jaredjennings/dactyl-keyboard/things/case-right-4x6.stl

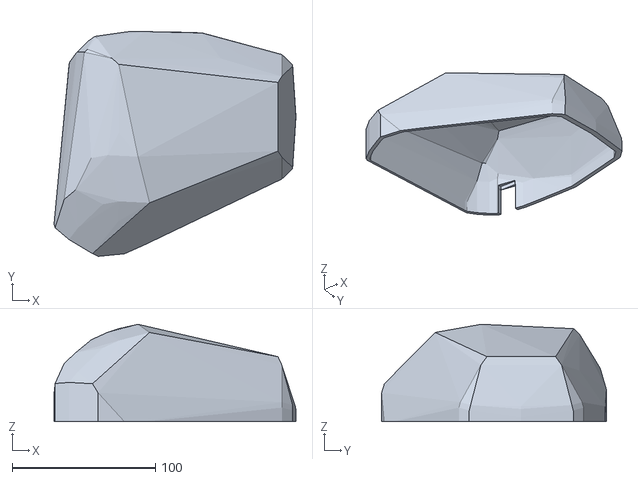
[picture p1: CAD file, 2021-05-06]
things/case-right-4x6.stl
169.1 x 157.1 x 68.1
