jaredjennings/dactyl-keyboard/things/left-6x6.stl

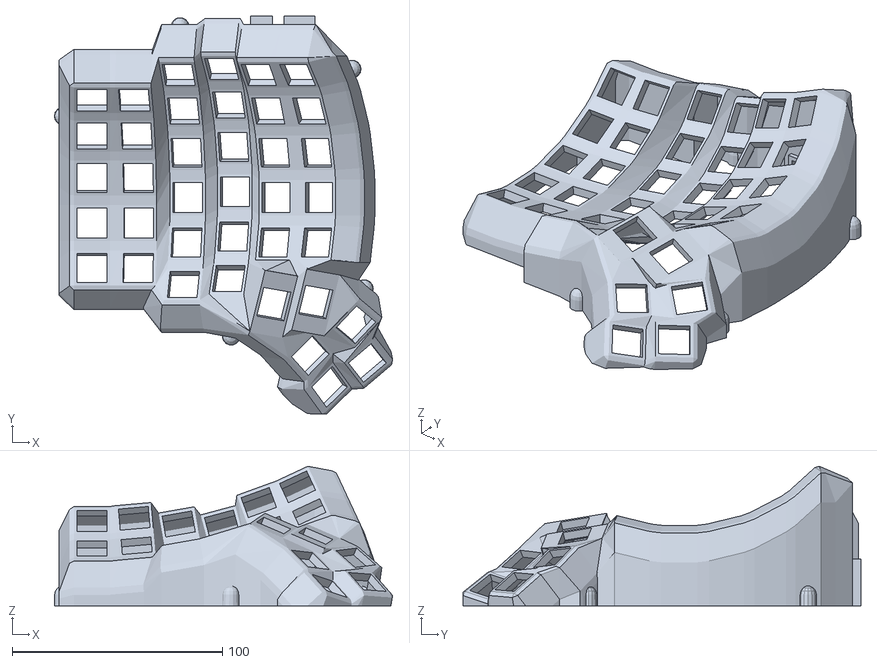
[picture p2: CAD file, 2021-05-06]
things/left-6x6.stl
161.1 x 189.5 x 66.4
