jaredjennings/dactyl-keyboard/things/case-left-5x6.stl

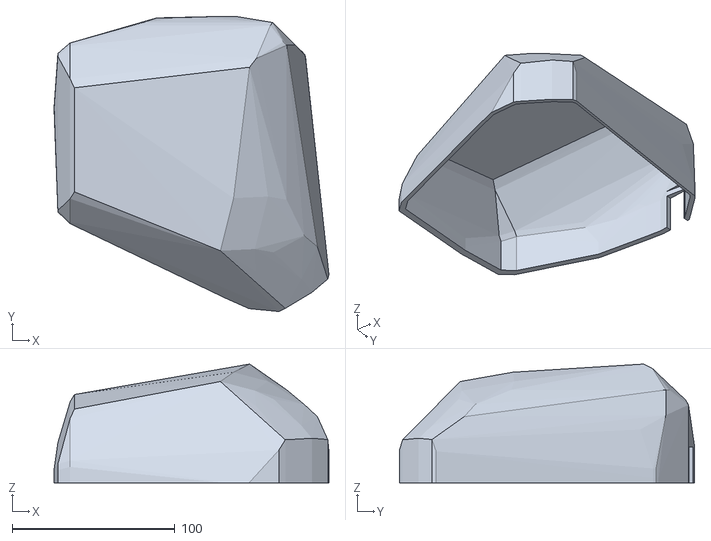
[picture p3: CAD file, 2021-05-06]
things/case-left-5x6.stl
169.1 x 181.5 x 73.1
