jaredjennings/dactyl-keyboard/things/right-4x5.stl

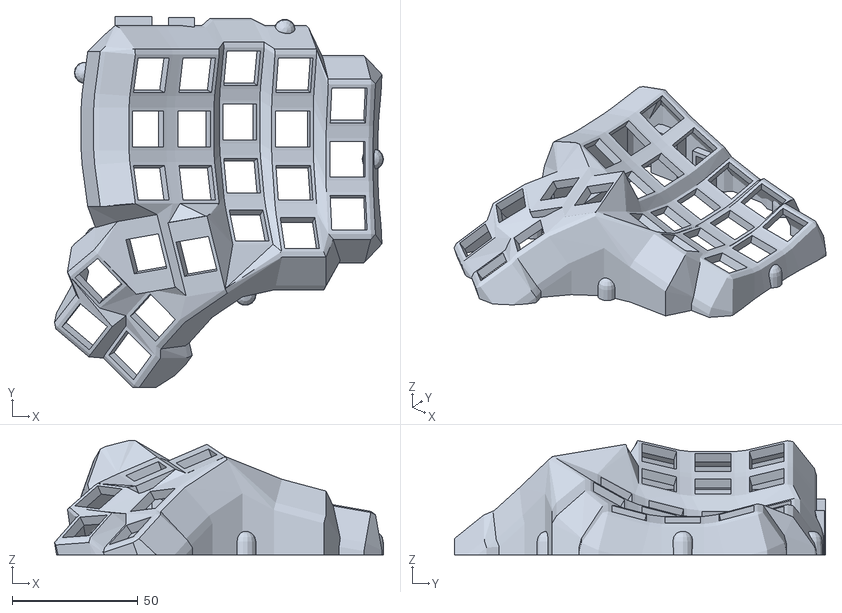
[picture p4: CAD file, 2021-05-06]
things/right-4x5.stl
131.0 x 147.9 x 45.6
