jaredjennings/dactyl-keyboard/things/case-right-6x6.stl

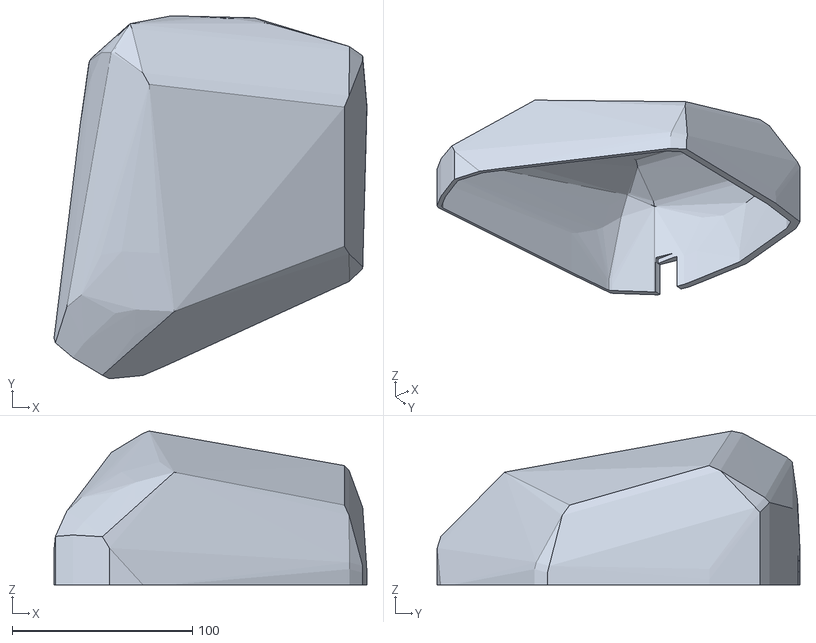
[picture p5: CAD file, 2021-05-06]
things/case-right-6x6.stl
173.9 x 201.4 x 85.5
