jaredjennings/dactyl-keyboard/things/right-5x6-plate.dxf

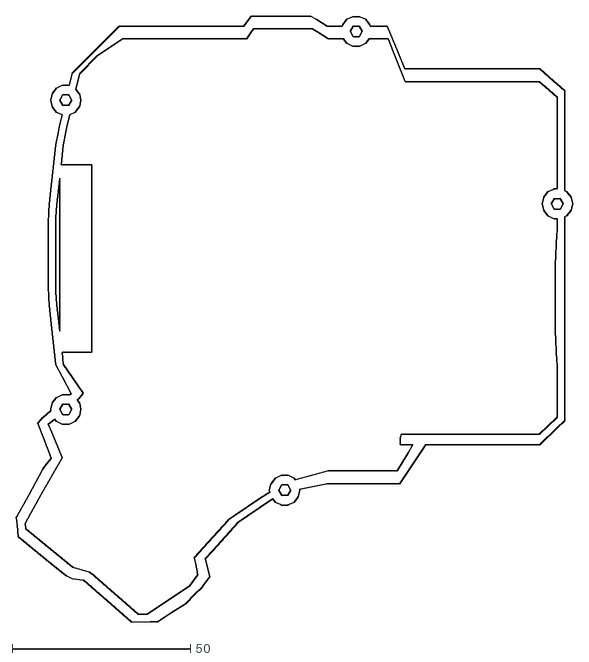
[picture p6: CAD file, 2021-05-06]
things/right-5x6-plate.dxf
155.8 x 169.8
