jaredjennings/dactyl-keyboard/things/right-4x6.stl

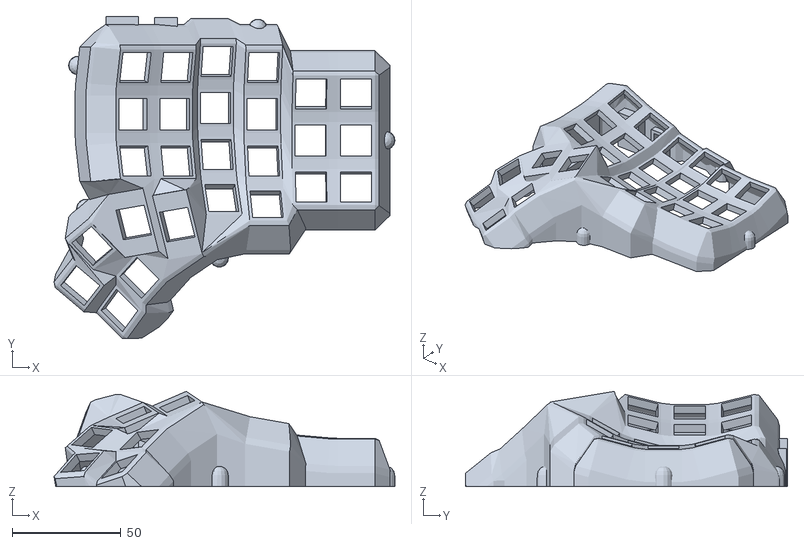
[picture p7: CAD file, 2021-05-06]
things/right-4x6.stl
156.6 x 147.9 x 43.8
