jaredjennings/dactyl-keyboard/things/right-6x6-plate.dxf

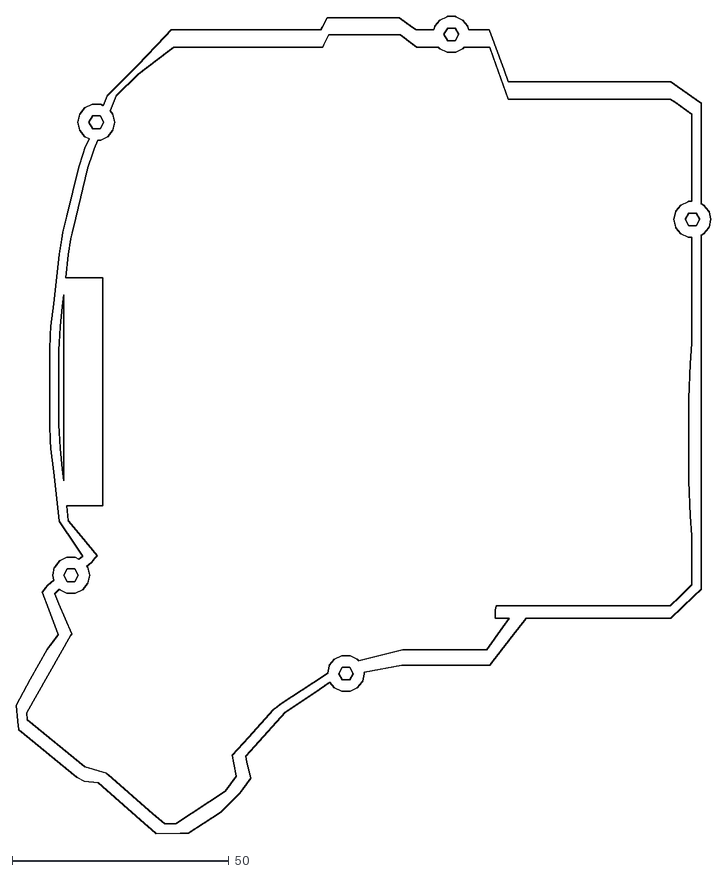
[picture p8: CAD file, 2021-05-06]
things/right-6x6-plate.dxf
160.3 x 188.5
