jaredjennings/dactyl-keyboard/things/left-5x6.stl

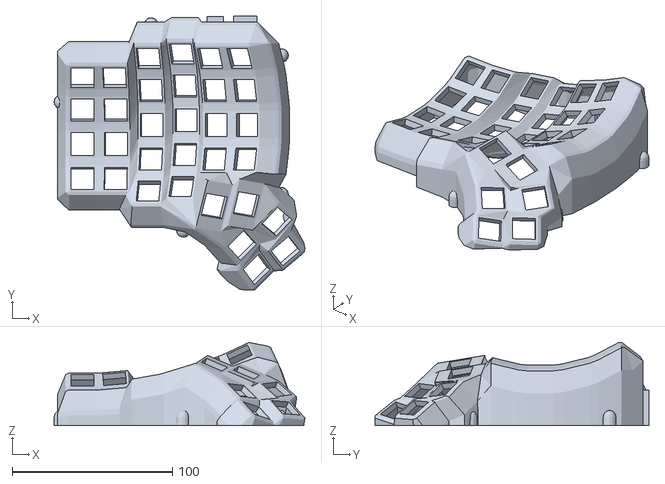
[picture p9: CAD file, 2021-05-06]
things/left-5x6.stl
156.6 x 170.8 x 51.8
