jaredjennings/dactyl-keyboard/things/case-right-4x5.stl

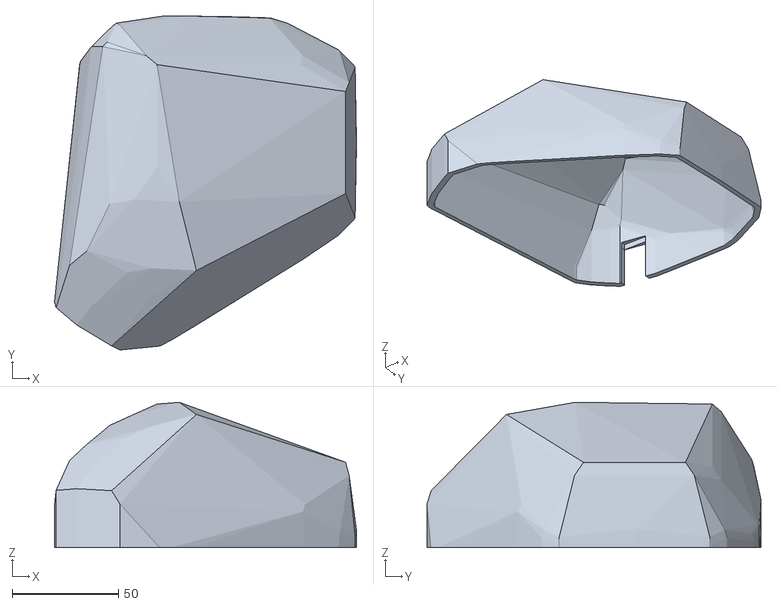
[picture p10: CAD file, 2021-05-06]
things/case-right-4x5.stl
142.1 x 157.1 x 68.4
