jaredjennings/dactyl-keyboard/things/left-4x5.stl

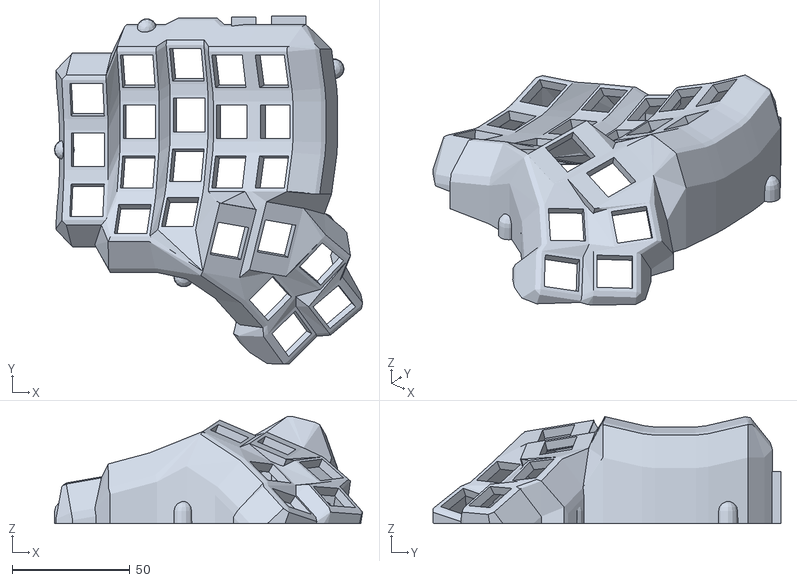
[picture p11: CAD file, 2021-05-06]
things/left-4x5.stl
131.0 x 147.9 x 45.6
