jaredjennings/dactyl-keyboard/things/right-4x6-plate.dxf

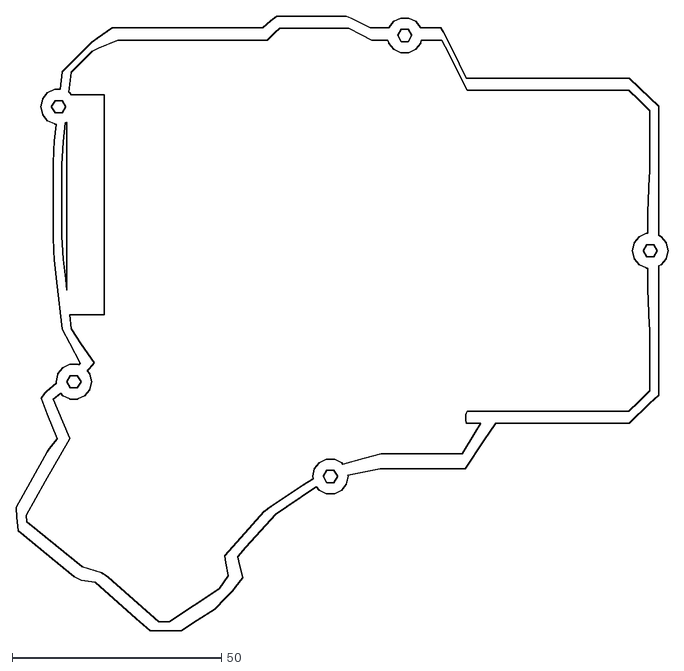
[picture p12: CAD file, 2021-05-06]
things/right-4x6-plate.dxf
155.8 x 147.0
