jaredjennings/dactyl-keyboard/things/right-4x5-plate.dxf

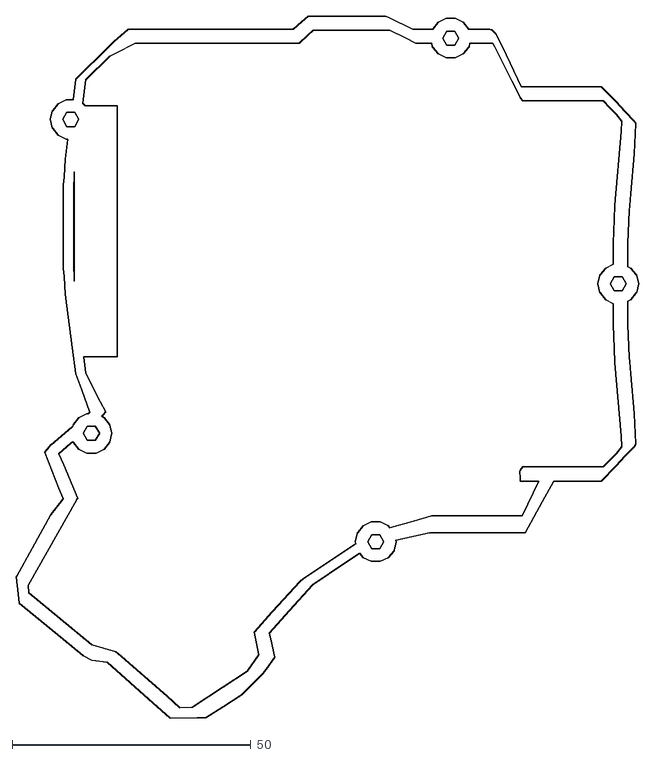
[picture p13: CAD file, 2021-05-06]
things/right-4x5-plate.dxf
130.2 x 147.0
