jaredjennings/dactyl-keyboard/(list of files, cad)

Other CAD files:
things/case-left-6x6.stl
things/case-left-4x6.stl
things/left-4x6.stl
things/case-right-5x6.stl
things/case-left-4x5.stl
things/right-5x6.stl
things/right-6x6.stl
