jaredjennings/dactyl-keyboard/(threads)

Thread 1 (2018-05-10):

feet

jaredjennings, 2018-05-10:
Add feet to the new bottom cover.

jaredjennings, 2018-05-27:
The feet story isn't over, but this is a start.

jaredjennings, 2018-05-27:
Oops, clicked while yawning.

jaredjennings, 2018-07-24:
[332b7ee] and the next five or so changes remove the solid bottom of [788c2eb], replacing it with legs that are separate pieces. Still no transverse holes. You know, I'm going to make that a separate issue, and call this one done.

Closed 2018-07-24.

Thread 13 (2018-05-10):

move code upstream?

jaredjennings, 2018-05-10:
Some of the 79 commits (at this writing) that I've done may be of general interest.

jaredjennings, 2018-05-10:
I looked through the commits. I think the only thing that really would go upstream is the renaming of the switch holes from "old" and "new" or whatever it was to "cherry" and "alps," and the addition of "kailh" without the nubs. But it's not clear that the way I did it is the way it should be done upstream.

Closed 2018-05-10.

Thread 14 (2018-05-10):

conventions

jaredjennings, 2018-05-10:
Use τ everywhere instead of π. Multiply by fractions instead of dividing. These and others like them are practices I've evolved over the past however long, which means not all the code follows them.

Thread 3 (2018-05-10):

rj-11 jack

jaredjennings, 2018-05-10:
Make a hole for an RJ-11 (modular 4P4C) jack, and figure out how the jack will be stuck into the hole.

jaredjennings, 2018-06-05:
I think it'll have to be glued in.

Thread 4 (2018-05-10):

attach bottom cover

jaredjennings, 2018-05-10:
The bottom cover needs to be attached to the frame. Probably by means of tubes run up from the bottom cover, with holes that those brass threaded inserts can be pushed into with a soldering iron. Also screw holes in the frame.

Closed 2018-05-31.

Thread 6 (2018-05-10):

Teensy bracket for LC

jaredjennings, 2018-05-10:
I bought a Teensy LC instead of a Teensy 2.0, because I felt like a renegade. This could have interesting firmware implications, but those are down the road. Right now, it's not quite the same size. Make sure it will work OK. Exact location is not important because of the Adafruit extension I bought.

And I think my code can either put a bracket on every piece of the frame or none. Look and fix.

jaredjennings, 2018-07-04:
Weeell, so far the dynamic behavior of the plastic hasn't been a consideration, nor the changes in its physical characteristics over time. Maybe I don't want to open that can of worms at this time.

jaredjennings, 2018-07-06:
OK, 9d0da13 adds the holder, but not the threaded-insert hole on the frame.

jaredjennings, 2018-07-06:
Ah, the holder should be centered on the screw hole, not the center of the Teensy board.

Closed 2018-07-07.

Thread 7 (2018-05-10):

thumb piece

jaredjennings, 2018-05-10:
A file is written for each finger piece (subset of columns), but none is yet written for the thumb piece. Fix.

Closed 2018-05-25.

Thread 8 (2018-05-10):

split bottom cover

jaredjennings, 2018-05-10:
The bottom cover needs to be split into pieces of suitable size, for the same reason as the frame and sides, i.e. to work on printers with a smaller build volume and so each piece will only take an hour or two to print.

Connectors should be added, to make it easier to glue.

This may end up with a need to define the cover piecewise, as it is with the frame and sides.

jaredjennings, 2018-05-23:
I tried immediately to define the bottom cover piecewise, and I started with the hardest piece: the one that includes the thumb. First I found that my definition needed to go one key place farther than my finished piece would, otherwise the piece would curve up at the edge. But then the interaction between the below-key prisms for the thumb and the finger, used for clipping the cover piece to size, got awkwardly 3D. I couldn't guarantee that one set of prisms would be exactly disjoint with the next, particularly around the upper left corner of the thumb.

So I removed my partial definition, resolving to intersect the entire bottom cover with several different prisms that cover the space, as was done with the sides before partially-defined sides entered the picture.

jaredjennings, 2018-05-27:
I did that, but quickly figured out that I'd need some slightly larger and slightly smaller prisms, so that I could define border regions and intersect them with connector shapes. That was not going to be easy - you can't just scale the prism, because it's defined somewhere else besides the origin.

Closed 2018-05-27.

Thread 16 (2018-05-13):

naming

jaredjennings, 2018-05-13:
There are several unfortunate naming decisions in the code.

Finger vs. thumb and key vs. thumb are one. I sort of like finger better, because after all the thumb has keys on it no less than the rest of the keyboard. I thought about having a configurable number of segments each with its own placement function, to get rid of all the hard-coding, but then decided this would only make sense if there were users with more than one opposable digit per hand. Not knowing of any, and not being one myself, this appears to be an unnecessary bit of (ahah) flexibility.

"Marshmallowy," "mallowy," "marshmallow," etc. were a more useful distinction when I was adding them into adereth's code and thinking of making them switchable; and the joy I felt at seeing them attached to my keyboard, and their roundness, reminded me of Homestar Runner saying, "marshmallow." But the adjective was always too long, and at this point it should go away.

There are three kinds of glue connectors at this point (well, two and a half), with another in the offing. The originals are stuck in dactyl.clj, as I recall to avoid circular imports. They need good names.

Thread 18 (2018-05-23):

make glue connector nubs slightly smaller

jaredjennings, 2018-05-23:
Not a lot. Just like a tenth of a millimeter. And only on the sides of the nubs: the height of the nubs is about right.

Closed 2018-05-25.

Thread 19 (2018-06-05):

add a flat place to clamp the thumb

jaredjennings, 2018-06-05:
The northerly glue paddle of the thumb angles up to the thumb frame, and there's no place for a clamp to press on. Add it so this paddle can be glued.

Closed 2018-06-11.

Thread 21 (2018-06-07):

bottom pieces too big

jaredjennings, 2018-06-07:
The second bottom piece took like 2 1/2 hours to print, with what turned out to be not nearly enough support inside. Split it in more pieces.

Closed 2018-06-07.

Thread 24 (2018-06-11):

frame-sides connectors missing from thumb frame

jaredjennings, 2018-06-11:
The thumb frame doesn't have any connectors on it.

Closed 2018-06-24.

Thread 25 (2018-06-11):

sides-frame connectors interfering with sides-sides connectors

jaredjennings, 2018-06-11:
The sides-frame connectors are too wide. You can't fit all the ones needed into the thumb part along with all the connectors between sides pieces. They only engage the frame-sides connectors along a fairly narrow strip. So make them narrower to match.

Closed 2018-06-23.

Thread 26 (2018-07-08):

USB bracket holes too small

jaredjennings, 2018-07-08:
It could be because they are pentagonal, or because I've confused their radius and diameter. But drilling one of them out didn't work well.

Thread 27 (2018-07-08):

too much downness

jaredjennings, 2018-07-08:
I finally got a piece of the sides and a piece of the frame that fit together. The sides piece was too far down: the keyswitch was visible below the keycap. Yes, some people like that, but that wasn't the idea for this keyboard.

Thread 28 (2018-07-08):

teensy holder slightly too small

jaredjennings, 2018-07-08:
Just got the Teensy pushed into the holder, and it doesn't quite close.

jaredjennings, 2018-07-24:
[0db44373dd] may be slightly too big. Find out next time

jaredjennings, 2019-02-08:
Pretty sure I got this dialed in right.

Closed 2019-02-08.

Thread 29 (2018-07-09):

clampability of bottom pieces

jaredjennings, 2018-07-09:
The bottom pieces need to be clamped together when they are glued. I just set two one on top of another when gluing, and they didn't quite mesh right and there are cracks. Such errors will certainly compound and result in a janky keyboard.

For pieces in the middle of the bottom, it's theoretically possible to clamp against something flat, although the vertical prisms are probably too big to actually do that. But pieces at the edge are angled up from the base toward the keyboard; there is nowhere for a clamp to gain purchase.

Two ideas I've had (thanks to other people at HackPGH) are to (1) make some kind of inverse of the side, whose outside is at right angles to the bottom; (2) add some kind of concave feature to the sides, where a clamp could gain purchase. It may in fact be necessary to do both: with an inverse piece made, why should it not slide against the side piece when they join at an angle? And this inverse piece should shy away from glue seams, so that if any glue gets out while the clamps are on, the inverse piece won't stick to the work.

In fact, up to now I've only thought of an inverse piece that encloses the whole side of the keyboard and is thus bigger than it; but maybe all that is necessary is some kind of straight-sided plug.

When I think of concave features, what I'm thinking of is a spherical dimple, maybe an inch around and a quarter inch deep. Once gluing is done, the dimple could be filled in in the Bondo stage (a thing I have not yet tried). But maybe if the feature is smaller in diameter relative to its depth - a quarter-inch cylindrical hole, perhaps? - less clamp slippage would occur.

Distantly a thought reoccurs. The first sides-to-sides connector I tried was some horizontal pins and holes. These failed miserably because the pins had to be supported, and the support was stronger than the pins and couldn't be removed. At the time, some people suggested I make holes on both sides and use pins of another material, such as metal. I kept iterating and came up with the hexagonal conical interface which is still unproven as a joint, but has turned out to be reasonably printable. But now imagine there are several holes that run horizontally through all the pieces of the bottom. Suitable interfaces are made for either end, with surfaces normal to the axis of the hole. The pieces are glued; interfaces and pieces are threaded on several threaded rods; washers and nuts are threaded on and tightened. Voila! Now, that only works for the present large block bottom. The original bottom was merely a curved panel, which would have feet of some sort attached; clamping things together in one axis when they are bowed out in another axis is a challenge. But the way we got to this bottom was by sidestepping the mystery of how the feet would look and how they would be defined.

Clear as mud what should be done, eh? But I had no other handy place to write these thoughts.

jaredjennings, 2018-07-12:
Ok - first we need smaller but wider vertical prisms: the places where they meet should have smaller teeth, but the pieces themselves shouldn't be much smaller.

jaredjennings, 2018-07-13:
OK, smaller teeth. Now the screw hole splits have teeth that are too small though

jaredjennings, 2018-07-13:
Is fix! So now we have more clampable sides pieces, but the problems with the ones on the end remain. And it's likely that the splits need to be tweaked again in order to avoid small shards of plastic at the edges.

jaredjennings, 2018-07-15:
I think it's time to hack in greater depth on the bottom. There is too much plastic there; it takes too long to print. Above provisions for clampability assume the current shape of the bottom, which needs to change. So I think I should change it, then consider clampability. And printability.

jaredjennings, 2018-07-16:
aaaggghhh this is why i left the bottom how it is for so long: change a single thing, wait *fifteen minutes*, repeat

jaredjennings, 2018-07-20:
Now the keyboard has legs [7898f325], which are a clampability issue of their own. But first the legs need glue tolerance.

jaredjennings, 2018-07-20:
ok glue tolerance added

jaredjennings, 2018-07-20:
The bottom pieces should now print in a finite time. But now they are less clampable than ever!

jaredjennings, 2018-07-21:
Now I'm thinking of some cutouts near the joints between bottom pieces. Home-plate-shaped, with the flat bottom parallel to the joint; in pairs, one on each side of the joint. Such cutouts could be clamped using spring clamps, which have been easy and successful in gluing the frame pieces together. The distance across which the clamp presses would be minimized, so the instability of pressing curved things together would be minimized. I can imagine a way to make home-plate-shaped inserts that can be glued into the cutouts. But maybe if I get smaller spring clamps, I can have smaller cutouts, and fill them in with Bondo or something.

jaredjennings, 2018-07-24:
I set out to print dactyl-bottom-00a, 00b, and 01a with lace holes. At 0.5mm radius, some of the holes were filled in. Nothing a hot wire can't fix, but gluing is enough postprocessing, without drilling out holes too. Aaand 00b failed to print like three or four times, so I don't have two pieces that go together that I can try lacing.

jaredjennings, 2019-02-07:
["Hah! We're back!"](https://www.cartalk.com/content/hah-were-back) I've got my own printer now and things are great. Issues still with the joining of the bottom pieces, but not with the means of clampability - I've laced up two pieces and glued them with SciGrip 4 to great effect. Closing this one then.

Closed 2019-02-07.

Thread 30 (2018-07-11):

that one weak spot in the thumb

jaredjennings, 2018-07-11:
one of the holes for the stabilizers in the thumb is lacking most of one of its sides. find and fix

Closed 2018-07-14.

Thread 31 (2018-07-13):

screw hole not deep enough

jaredjennings, 2018-07-13:
The screws I got are slightly too long to go through the frame and stop before the end of the threaded insert. So you screw the screw in as far as it will go, and it doesn't hold the frame tightly against the screw hole.

(And the hole in the plastic already wasn't quite deep enough for the insert to be pushed down far enough to be flush, by a half millimeter or so.)

Consequently the ... how you say, boss, in the screw-hole, needs to be deeper.

Closed 2018-07-15.

Thread 32 (2018-07-13):

frame-sides connectors not clampable

jaredjennings, 2018-07-13:
The frame-sides connectors with their angled interface to the frame look good and are well-printable, but cannot be clamped against. Make them boxier.

Closed 2018-07-14.

Thread 33 (2018-07-24):

sides and bottom different thicknesses?

jaredjennings, 2018-07-24:
The sides printed at 3mm thickness (well, the one piece I have) are satisfyingly solid but take forever to print. So I reduced the sides-thickness to 2mm. But then I printed the new, legs-having bottom, and it was a wide expanse of plastic 2mm thick, which turns out to be quite flexible. The possibility remains that when glued together several pieces of this stuff will be stiffer; but the possibility also remains that I'll drop it some day. On the gripping hand, neither will happen if the pieces take so long to print that I never have them in hand.

Anyway, I still haven't tried the sides at 2mm, nor the bottom at 3mm. Having these values independent might be helpful.

Thread 35 (2018-07-24):

put a raspberry pi inside

jaredjennings, 2018-07-24:
Get a Pi Zero W and a battery. Stuff them inside the keyboard. Run connectors (e.g. charging, video) to the edge of the keyboard. Figure out how to put some part in the left hand too so the right hand isn't markedly heavier.

jaredjennings, 2018-09-21:
https://reddit.com/u/ILWrites is designing this sort of thing, really thoroughly it appears, although of course not for my particular keyboard.

e.g. https://www.reddit.com/r/MechanicalKeyboards/comments/9dhhj1/quick_update_on_the_mk_project_ive_been_working/

Thread 37 (2018-07-25):

smaller edition

jaredjennings, 2018-07-25:
The really small one (what, 2x2 finger) never really worked right. It wasn't a serious effort, just an attempt to reduce rendering times. But there should be a smaller size - what, 3 rows by 5 columns, or so? - it would probably work better, and some people would want it, and maybe its pieces will print faster...?

jaredjennings, 2018-07-25:
Created #38 about the thumb.

jaredjennings, 2023-05-03:
Boy howdy, I tried 5 columns - twice now - and I didn't like it.

Thread 38 (2018-07-25):

Vary thumb

jaredjennings, 2018-07-25:
The thumb is hard-coded. I don't think it can be shoehorned into maps and lists like the description of other parts of the keyboard found in the layouts variable in layout.clj; but it should be factored and packaged so you can at least write another thumb, and say this layout has thumb A and this one has thumb B.

jaredjennings, 2018-07-28:
Ok wow #37 and this one are causing some second-system effects for me.

As against what Adereth wrote, a big part of what I've done is to try to pull out constants and put them in one place, with the idea that they could be swapped out wholesale. This has led my thoughts in the direction that the constants written in layout.clj are the definition of a keyboard, written in a highly domain-specific, very-low-abstraction-power language. There are two problems here: (1) the feeling that my Lisp program ["contains an ad-hoc, informally-specified, bug-ridden implementation of Lisp"](https://en.wikipedia.org/wiki/Greenspun%27s_tenth_rule); (2) the thumb is written in a lower-level, high-abstraction-power language.

Every time I try to think seriously about fixing this (in the last few days), I end up thinking larger thoughts instead: either (1) that the whole idea of the constants is wrong, and this top level of keyboard abstraction should be made out of macros or functions or something; or (2) that I haven't gone far enough, and I need to distill more ideas about how to specify the essence of a keyboard apart from the shapes that make it up. But I'm on shaky ground: (1) the constants are not in fact all in one place at all, I've defined more that are scattered through the code; (2) there are many hacks: the added block for the thumb glue connector to make it clampable, the extra keys specified in the prisms that cut out the inside of the sides gasket, and such like.

jaredjennings, 2018-07-31:
Actionable problems:

1. The thumb contains rotated keys and keys of different sizes. These must be connected by different connectors.
2. The connectors between the thumb and finger are a special case.
3. Irregularities in the key prisms regarding the thumb.

jaredjennings, 2019-05-20:
I finally have an answer for (1), I think. The things defined in layouts seem tantalizingly like a declarative description of a keyboard aching to become code, but the way they are used is as data. With code, if you remove some of it, it doesn't execute, or describe, or whatever the code does. And it only gets called when you call it. But this is data: it is accessed from all over the place, unpredictably; if you don't write some of it, you get errors, because things requested are unset. It is a form describing the particulars of your keyboard, handed to a rigid, predefined process. Only in the ways the process has been made flexible is it flexible. And the process is what makes it a Marshmallow. The hacks may be feasible as hooks: code, but at the call of the rigid process; directions written into a long blank on the form. Put this way, it all seems bureaucratic, not elegant; but with the lengthy form it is after all more flexible than what I started with.

Thread 39 (2018-07-28):

make it a container

jaredjennings, 2018-07-28:
I didn't mind getting Clojure and OpenSCAD running, but it could be a barrier for someone. And if this program ever gets as flexible as I imagine (#37 and #38 are only the beginning, but probably not as flexible as https://github.com/HalFrgrd/UniversalKeyboardDesigner/blob/master/README.md), it would be annoying putting all the scad and stl files in the repo and keeping them up to date.

It's not that much easier or less developerish to get Docker running, so I guess the idea with making all this into a container would be to make a web app of some sort that would generate the STL files for a keyboard in your choice of forms: size of the finger part (number row? F-key row? extra Y and B keys?), shape of the thumb part (less keys, more keys, 2u or 1u keys, maybe manuform), shape of the sides (sphere, cylinder, octahedron, etc), column staggering amounts; and cache them so people can link to them with a really long URL, like you can with KLE.

This would cost money to host, and it is a great deal of work on top of the keyboard itself, and I don't know if anyone actually wants it, and I don't know if I'm the person to make it for them even if they do. But now, having written this idea out, I can safely forget it and think of other things.

jaredjennings, 2020-08-18:
http://dactyl.siskam.link exists

Thread 40 (2018-08-20):

changing downness has broken sides

jaredjennings, 2018-08-20:
The half-circle connectors between sides pieces, and the sides-to-frame connectors, appear to be constructed incorrectly, because changing the downness of the sides has ... made these pieces work wrong.

Thread 42 (2018-08-21):

curvy vertical prisms?

jaredjennings, 2018-08-21:
The vertical prisms yield pieces with points and edges. These tend to be exaggerated by the 3D printer, leading to surfaces that contact each other only poorly, and are difficult to improve by sanding.

Try adding more polys to the vertical prisms, to make them curvier; see if this yields a better fit.

jaredjennings, 2018-08-21:
Also if you have more lace holes (#43) you have more places where the orderly flat and angled vertical prisms are interrupted

jaredjennings, 2018-08-25:
Ok, hacking the hexagonal vertical prisms into sinusoidal ones worked initially, but then making those bumps appear where I wanted on the half-circle connectors (#44) proved to be very difficult, and involved factors and addends that, for example, changed when I changed the period of the sines, or when I changed the resolution of the thing. And it was slow. So I'm undoing the whole thing, reopening this issue, and I'm going to do the work in a branch.

jaredjennings, 2018-09-11:
The commits of the eggcrate-splitters branch, just merged, fix this properly.

Closed 2018-09-11.

Thread 43 (2018-08-21):

more, smaller lace holes

jaredjennings, 2018-08-21:
I glued together a couple of pieces with the current set of lace holes. The laces were easy to thread, and I think the joint may have worked (one of the pieces is much weaker than the joint so it's hard to tell), but the laces ran along the pieces more than across them, such that the force of pulling the laces was poorly converted into force pulling the pieces together.

jaredjennings, 2018-08-25:
See https://github.com/jaredjennings/dactyl-keyboard/issues/42#issuecomment-415967898. Reopening, backing out, and redoing the work in a branch.

jaredjennings, 2018-09-11:
The commits of the eggcrate-splitters branch, just merged, fix this properly.

Closed 2018-09-11.

Thread 44 (2018-08-21):

use vertical prisms for half circle connectors

jaredjennings, 2018-08-21:
If sharp points aren't good for the connections between pieces of the bottom (#42), then they aren't good for the connections between the sides either. And those darn cones never quite lined up right anyway. Use the vertical-prisms surface for the connections between sides, in the same way as they are used for the screw holes. Then any advancements made will apply to nearly all the connections in the keyboard. (The glue paddles are too small and thin to use this design.)

jaredjennings, 2018-08-25:
https://github.com/jaredjennings/dactyl-keyboard/issues/42#issuecomment-415967898. This is the thing that wouldn't work given the way I had hacked the curvy bits onto the vertical prisms.

jaredjennings, 2018-09-11:
The commits of the eggcrate-splitters branch, just merged, fix this properly.

Closed 2018-09-11.

Thread 45 (2018-08-25):

with hacky curvy vertical prisms, sides-to-frame connector borked

jaredjennings, 2018-08-25:
This should work itself out as the rewritten eggcrate box is integrated, but it's an issue.

jaredjennings, 2018-09-11:
The commits of the eggcrate-splitters branch, just merged, fix this properly.

Closed 2018-09-11.

Thread 46 (2018-09-03):

Combining with RollerMouse Red

dfenn, 2018-09-03:
I'm interested in how you've split this up into pieces. I have a 3D printer with a small printing volume, so the only way I'd be able to print it would be in pieces.

I'd like to combine a Dactyl with the RollerMouse Red (https://www.contourdesign.com/product/rollermouse-red/). To do that, I think the roller would have to butt pretty close up against the thumb cluster, so that the keyboard wouldn't be too far away.

I think that to do that, it would be necessary to remove the marshmallow part on the front edge, and the height may have to be adjusted. I've looked through the source files, but I'm not sure where to start to accomplish these.

Can you give me any pointers about how I might accomplish that?

Thanks!

jaredjennings, 2018-09-04:
@dfenn, welcome! The height is adjusted in things/key-place.scad in the KeyPlace and ThumbPlace modules. Since it's raw OpenSCAD code, if you adjust it while you have dactyl-top-right-all.scad open in OpenSCAD, you'll see the changes immediately.

For the marshmallow part, first you would need to make the sides not go all the way around the keyboard, and then you'd have to figure out how to split the resultant sides in pieces and how to attach them.

The sides are defined in sides.clj; right at the end, [`sides-right`](https://github.com/jaredjennings/dactyl-keyboard/blob/11f57b17ae8c23b1b7689550111812c5fe6c5862/src/dactyl_keyboard/sides.clj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) is defined as a closed sides object (last argument true) whose, ah, shall we say points, are `around-edge`. You probably want to make a copy of [`:around-edge`](https://github.com/jaredjennings/dactyl-keyboard/blob/11f57b17ae8c23b1b7689550111812c5fe6c5862/src/dactyl_keyboard/layout.clj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), which is in layout.clj's `:y-and-b` layout, and call it `:sides-exist-at` or something. (`layouts` was supposed to be a way to define multiple sibling keyboards, e.g., different sizes, and choose one to render. That has not happened yet. See #37 and #38.) [Below the `def layouts`](https://github.com/jaredjennings/dactyl-keyboard/blob/11f57b17ae8c23b1b7689550111812c5fe6c5862/src/dactyl_keyboard/layout.clj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), around line 100, are a bunch of mentions of `chosen-layout`. That's how the key `:around-edge` in the `:y-and-b` layout becomes the global variable `around-edge`. So add a new def there for `sides-exist-at`. Now make `sides-right` at the end of sides.clj use `sides-exist-at` instead of `around-edge`, and pass false as the last parameter because your sides shape is no longer closed.

To change how the sides are split into pieces, change [`:sides-partitions`](https://github.com/jaredjennings/dactyl-keyboard/blob/11f57b17ae8c23b1b7689550111812c5fe6c5862/src/dactyl_keyboard/layout.clj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) in layout.clj (see output file `splits-right.scad` for the results of your changes), and change `:sides-slice-joints`, immediately following, to match.

The sides are glued to the frame using the [`:sides-frame-joints`](https://github.com/jaredjennings/dactyl-keyboard/blob/11f57b17ae8c23b1b7689550111812c5fe6c5862/src/dactyl_keyboard/layout.clj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). Some of these will no longer join the frame to anything once you have removed the front of the thumb, so you'll have to change them.

All of these things are specified using a family of rather compact notations. The somewhat exact meaning of the `:sides-slice-joints` notation, for one, is [in the docstring of `intersects-from-notation` in sides_pieces.clj](https://github.com/jaredjennings/dactyl-keyboard/blob/11f57b17ae8c23b1b7689550111812c5fe6c5862/src/dactyl_keyboard/sides_pieces.clj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). `:around-edges` notation eventually gets passed to [`sides-place-fns`](https://github.com/jaredjennings/dactyl-keyboard/blob/11f57b17ae8c23b1b7689550111812c5fe6c5862/src/dactyl_keyboard/layout.clj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), and is documented there.

Generally, though, `k` means key-place, and `t` means thumb-place. On the right side of the keyboard, which is the primary one modelled, `k` column numbers (-1 through 5 inclusive, see `:columns-pieces`) go up as you go to the right (aka east), and row numbers (0 through 4 inclusive, see `:rows`) go up as you move away from the user (aka north). `t` column numbers (0 through 2 inclusive) go up as you go to the left, and row numbers (-1 through 1 inclusive) go up as you move away from the user. The details, like `[:n :k 3 2]` or `[:w-of-k 3 2]`, are modifications of those places on the keyboard, inexpertly specified.

Hope this helps; please ask more questions.

(You know, looking at it from the top, you might want to shave some of the marshmallow off of the near right corner too... hmm.)

dfenn, 2018-09-05:
@jaredjennings, thank you for the detailed response. I'm hoping to have some time this weekend to look into this. I'll keep you posted on how it goes, and I'll ask you more questions as necessary.

Thanks!

jaredjennings, 2018-09-09:
I've done the first part of this in 62da0d1ceb3b29cdbd01853ff356c28cdd277459 (no attention to how the sides are split into pieces, nor attached to the frame). This brings up the issue that the bottom is still defined under a place where the sides don't exist -- screenshot: https://imgur.com/Ksts5kO.

jaredjennings, 2018-09-18:
A possibly simpler thing to do is to change the shape used to form the marshmallow. Twice in sides.clj, the form ```(sphere r)``` occurs. If you change that to, say, ```(scale [0.5 0.5 1] (sphere r))```, it doesn't stick out as far in front of the keyboard. (Nor as far out from any of the sides.) Any convex shape will do - I've tried it with cubes and cylinders of various rotations, too. The reason it has to be convex is that a piece of it is hulled with a connector body to make the sides-frame connector, so if it's concave, you'll have bumps on the outside wherever there's a connector.

You know, it might be fun to vary the shapes hulled by position. If you were to use a cylinder rotated onto its side for the southernmost positions, you could achieve a flat front while still having the case exist there, and it would probably blend well with the spheres used everywhere else. (To be clear, the code as it stands doesn't support that. But it would be a pretty small change.)

dfenn, 2018-10-01:
Sorry for the novice question here, but how do you view the side pieces? When I view the sides-right-0*.scad files, not much shows up. It just looks like some very small pieces.

Also, are the sides required for structural support, or are they purely aesthetic? If they're just aesthetic, I may try doing a preliminary print without them just to see how the keyboard would feel with the RollerMouse. I'd rather not invest a lot of time tweaking things if it turns out that the Dactyl and the RollerMouse are going to be a bad combination anyway.

dfenn, 2018-10-02:
Turns out that was user error on my part. This is the first time I've used OpenSCAD, and I didn't realize there was a difference between previewing and rendering. The previews weren't working right, but as soon as I rendered, I was able to see everything fine.

jaredjennings, 2019-12-29:
Closing due to inactivity.

jaredjennings, 2021-11-05:
https://www.reddit.com/r/ErgoMechKeyboards/comments/qmujxm/lily58_wireless_with_rollermouse_setup/

Closed 2019-12-29.

Thread 48 (2018-09-15):

lace holes in the wrong places

jaredjennings, 2018-09-15:
When I made the eggcrate-splitters, I left some room between where the eggcrate splits the plastic in two pieces and where the holes are where you lace the pieces together while gluing.

One problem has shown up two ways: I printed the first bottom piece, and it had holes on its left edge. This means it isn't wide enough, and it also means the lace holes need to be closer to the split.

jaredjennings, 2018-09-15:
Oh and the last piece has a couple of little bites out of it because the last double eggcrate box doesn't cover the rightmost edge entirely

jaredjennings, 2018-10-01:
OBE #50. There will be another "tweak hexagonal pieces, splits are in the wrong place" ticket.

Closed 2018-10-01.

Thread 49 (2018-09-15):

eggcrates too small on sides-frame joints

jaredjennings, 2018-09-15:
After eggcrating the sides-frame joints and printing once, I find that the waves have too great frequency.

Closed 2018-09-15.

Thread 50 (2018-09-23):

hexagonal eggcrate splitters

jaredjennings, 2018-09-23:
Presently the eggcrate splitters are shaped sort of like eggcrates: wide, deep, but not tall; the bottom of each tray fits into the top of the next. Only they are stacked along the x-axis not the z. Their effect is to slice the bottom of the keyboard into long, thin strips. I've spent many evenings trying to tweak their thickness and offset (and the similarly shaped but pointier triangular-wave-oid splitters before them), such that there are no bites taken out of the leftmost or rightmost edge of the bottom, and no little bits hanging off the edge of any of the pieces, or even floating in midair. Every tweak takes like 10 minutes to show up, by which time I've moved on to something else and don't get back to it until 20 minutes later. And whatever OpenSCAD has to do to figure out how it's shaped, there isn't a progress bar for that.

I wanted to minimize the number of glue joints used for the bottom, and simplify them as much as possible, but the larger I make the pieces, the longer they take to print. And every piece (except for the first one, which is mostly the part of the thumb that sticks out) is as long as the whole depth of the keyboard (north-south). If I print it standing up to reduce the time and plastic taken up by printing support, the layer lines go across the width of the piece rather than along its length, making it weak.

So the bottom needs to be split along more than one axis. To just split it into rectangular pieces may not be the best, because four would have to meet in one place, and that place could be troublesome. With triangular pieces, six meet in one place. With hexagonal pieces, though, only three meet in one place. - Come to think of it, by alternating splits, like bricks are laid, you could have only three rectangular pieces meeting in one place. Meh, hexagons are cooler.

jaredjennings, 2018-10-01:
The egghex branch has been made, and merged. It has not been extensively tweaked, and OpenSCAD still takes 10 minutes of unresponsiveness per open bottom section. There are divisions that run through screw hole bases. We'll leave those for other tickets though.

Closed 2018-10-01.

Thread 51 (2019-02-07):

join bottom pieces better

jaredjennings, 2019-02-07:
So I made the bottom pieces bigger [7da24ba], since I don't have to stop printing, clean up and ride home cause I got my own printer. But the waves at their joints are too small to sand, and when I do, too much of them is removed. They need to be bigger. The reason I made them smaller is to obtain more precise alignment of the pieces, particularly vertically. But little imperfections in the print spoil the alignment.

So bigger waves. Would rotating them work better for vertical alignment? Or maybe they should be polar? A more complicated wave than a sine? Maybe I should cut irregularities with a little cutting bit, instead of trying to sand them? I need a good way to find them first. Like when you go to the dentist, they do something to your teeth, and then they check your bite with carbon paper and grind down here and there till all your teeth fit together just right again. Except my plastic is presently black. Powder of some kind? Flour?

jaredjennings, 2019-05-19:
Making the waves gentler just let pieces shear against each other in the z axis without anything to stop them. I'm using Sci-Grip 4 now, which solvent-welds the pieces; I'm not sure whether it softens them where applied, but it ought to. Also filing everything is annoying and doesn't always make it fit better. Sometimes there are gaps, even without having filed much material off. The Fourier box https://gitlab.com/jaredjennings/fourier-box has this problem, but I spent 30 hours printing it so I'm just going to make it work somehow. Probably with epoxy.

jaredjennings, 2020-09-20:
The way I solved it with the Fourier box was with friction welding. I clamped the pieces together, friction welded the entire seam on one side, friction welded a dotted line on the other side, and squirted Sci-Grip 4 in using a little bottle with a syringe tip. I got too happy with the clamp on one joint, and the resulting box failed to be flat. It still works, but it's not that great.

So I'm not still doing a pieced bottom, because I'm not doing an extra column anymore, so fingers crossed the whole bottom fits on my printer. My leading hypothesis about how to proceed with piecing is to stop trying to make the pieces contact each other across the whole joint, and instead make some sort of alignment jig that fits into the pieces in small places, like a big asterisk whose points are small balls that fit each into dimples on the model. *handwave* This then is what puts the pieces in the right position and orientation relative to each other, rather than the surfaces of the joint. Then friction weld the joint, to fill in plastic, then Sci-Grip it for good measure. Oh - 3D pens are also a thing - I saw a guy who matched two broad flat curved surfaces by scribbling across the joint with a 3D pen. I don't have one of those.

I haven't tried any of that above, so it might be another six-month boondoggle. As long as it's not in the way of making a keyboard, I'm not doing it yet.

jaredjennings, 2020-09-20:
I'm going to close this so I don't get demoralized by all the open issues. Then later when I'm dealing with pieces again I'll fish it out and reopen it.

Closed 2020-09-20.

Thread 52 (2019-03-21):

continuous curvature

jaredjennings, 2019-03-21:
Thatothermofo has brought to my attention the idea of continuous curvature in product design. https://www.reddit.com/r/MechanicalKeyboards/comments/b3soxi/once_youve_seen_it_you_cant_unsee_it/

At present there are discontinuities in the curvature of the sides and bottom of the keyboard at every point.

To fix, stop taking the hull of this and that, and instead define their shapes as continuous functions, whose first derivatives are constrained to be zero, for example, within 3mm of a keyswitch hole. Stopping using hull would enable the use of Five to model the keyboard, although defining and evaluating such functions as these make me think more of solving than drawing or describing. Either way it may be so much change as to compel a completely different project.

jaredjennings, 2019-05-18:
With the experience of https://gitlab.com/jaredjennings/fourier-box, I can say this could probably be done with some Bezier patches fairly easily, and in OpenSCAD. That would surface the old problem, though, that key-place is a function that translates objects, and not a function that transforms point coordinates. Bezier patches need points. Also the look of the keyboard would be determined by the positions of control points, rather than the shape used for pairwise hulling. And there could be some (if you will pardon the pun) corner cases, too...

jaredjennings, 2019-12-29:
So I tried this in Five. It turned out to be sort of easy to write a function that could displace an axis-aligned slice of any shape, so as to deal with the column staggering. I got it to use a piece of sine wave to interpolate between the non-displaced and displaced parts. Then I figured I would write another function that takes something flat and curls it up at the edges. This was quite difficult and I never succeeded at it. You can't abstract things very much in libfive, because it takes the code you write and translates it into a tree of C++ objects, and all the objects have to do directly with math on x, y, and z; so I couldn't take tricky or repeated bits and put them in functions. I tried some macro magic, which did not ultimately work.

And then I started browsing patents. I found the old IBM patent, where the columns grow apart from each other as you go north (my term not theirs) on the keyboard. I found the idea of columns whose profile is spiral not elliptical, because the joints of the finger place the tip of the finger along a spiral as the finger is curled up, not along an ellipse. And this let me know that all the work I'd done to curl up a flat shape along the surface of an ellipsoid was not as well-founded and invariant as I thought. That means I need to think about the shape of the keyboard more before I use something as brittle as libfive to express it. And that means work for this issue takes a hiatus.

jaredjennings, 2021-07-04:
https://www.reddit.com/r/ErgoMechKeyboards/comments/oc68nu/blended_dactyl_manuform_new_variant_written_in/

Thread 53 (2019-03-25):

export complicated mid-build objects to STL

jaredjennings, 2019-03-25:
I'm watching four ```openscad --render```s trundling away and pondering about how all four are thinking about what the bottom of my keyboard is shaped like. It's a big waste of effort, and it means a lot of time is wasted too. I'm just playing with the parameters that describe the edges of the pieces of the bottom, trying to arrive at values that reliably result in pieces that fit together with a minimum of postprocessing. Every time I do, I need to wait like ten minutes for the scads to build into stls. If only OpenSCAD had some kind of restart file like CFD solvers do, and I could tell it in some way that this piece of the bottom and this other piece of the bottom differ only in which piece got cut out, not what the bottom is shaped like.

Well - such a file exists: it is an STL file. If I rendered the whole bottom in one STL file, the pieces of the bottom would be defined like

```
    intersection() {
        import("bottom.stl");
        hex_prism_of_grid(...);
    }
```

Easy peasy, then I just have to write a few more dependencies in the build system (```dm-r-bot*.scad``` now depend on ```dm-r-botwh.stl```, or some such). And it ought to be a lot faster too, what with only figuring out what the bottom is shaped like once. The same could be applied to the sides.

I've exerted so much effort to push parts of the definitions of these complicated objects down into SCAD code, but never thought of pushing it all the way down to an STL. How silly of me!

jaredjennings, 2019-05-18:
Ok, b1e7d09 builds all STLs (for both hands) in 56 min, where 1283c8a built in 129 min. That's good.

I thought about doing this with the sides, too, but I already did that thing where I defined pieces of the sides rather than the whole sides. It's fairly likely that if I undid that and used intermediate STLs instead, it might be faster, and would very likely be simpler.

That work should probably happen in a branch. I'm going to leave this one open till I try it, but I may not do that immediately.

Thread 54 (2019-03-30):

registration widgets

jaredjennings, 2019-03-30:
The bottom of the keyboard has somewhere from 3 to 15 pieces (depending on how big I tell them to be). Other than all of them being just the right size and also fitting together perfectly (hah!) I don't know how I'll know they add up to the right size and shape.

If there were a hole, or a bump, or something, in the middle of each bottom piece, I could measure their distances, find out what a ... what a sanding and gluing job I did, and get better at it. I could even imagine printing jigs that mate with these registration widgets, and are easier to 3d-print and get right; when gluing some bottom pieces together you could attach the jigs, then remove them when done.

jaredjennings, 2019-03-30:
OK but if they are holes they have to be normal to the surface, not vertical. - Spheres don't change under rotation. Spherical dimples would only have to go in the right position. I think I wanted holes I can fit my vernier caliper into, though. With any kind of dimple or bump, where exactly on the feature should the caliper jaws go? But the holes must not be exactly normal: the sides of corresponding holes must be parallel. If they are both normal to the surface, they will be at angles to each other.

jaredjennings, 2019-03-30:
This is to say nothing of the problem that sank the clamp holes idea: there's already stuff on both the top and bottom surface of the bottom piece; any holes or bumps should avoid these existing features, and then how do you properly express where the hole or bump goes, without trial-and-error manual positioning? And such work would be instantly wasted if you change the size of the bottom pieces, which I've done a lot to trade risk of piece misalignment against time to print and iterate.

jaredjennings, 2019-06-10:
Weak idea: small spherical dimples the size of BBs. Buy AirSoft plastic BBs and glue them into the dimples. Use the calipers on the glued BBs.

Thread 55 (2019-04-27):

reduce leg sinusoid amplitude

jaredjennings, 2019-04-27:
Having glued a few legs on, I can see that there is not much contact area between the leg and its base. Make the joint less waffly and more flat. Not all the way flat but flatter. The period of the waves is about good - some two complete waves across a diameter of the leg. Just lower the amplitude.

jaredjennings, 2019-12-29:
Pretty sure I did this at some point.

Closed 2019-12-29.

Thread 56 (2019-04-27):

wacky voronoi splitter

jaredjennings, 2019-04-27:
The objects used to split the bottom of the keyboard are regular hexagons. I don't want a leg joint or screw hole base to be split into two pieces by these splitters. But optimizing both the size and offset of the splitters to avoid this is tedious and manual. Couldn't we just construct the splitters from a Voronoi diagram where each feature of the bottom gets its own cell?

Or with large enough hexes to make the bottom only a few pieces will it not matter enough to spend the work?

jaredjennings, 2019-12-29:
Splitting the bottom into any kind of pieces for printing and gluing it back together hasn't proven to be much of a tractable problem. Postponing this indefinitely.

Thread 59 (2020-08-17):

Automatic placement of the switches footprints on a pcb

Supermagnum, 2020-08-17:
Since the position of the holes for the switches is known, there should be possible to add a utility that places the footprints of the switches on a PCB according to the geometric layout of the keyboard halves.
Placement on the pins for ALPS switches:
https://matias.ca/switches/click/blueprints/3.jpg
Cherry switches:
https://www.cherrymx.de/en/dev.html

Hybrid footprints for Kicad ( he should have used a oval hole, its easy to spot where )
https://github.com/ai03-2725/MX_Alps_Hybrid

Kicad has a python API:
https://docs.kicad-pcb.org/master/en/plugins/plugins.html

jaredjennings, 2020-08-17:
This is a great idea. It requires flexible printed circuits (FPC), or [wiggles and weaves](https://www.reddit.com/r/ErgoMechKeyboards/comments/i83bw5/wiring_ideas_for_the_dactyl_wiggles_and_weaves/), owing to the 3D nature of this keyboard. It's not a high priority for me, because so far I've just handwired them. I'll also note that gEDA PCB has a text-based file format. I'm not sure how easy KiCAD's file format is to write, or how stably it is defined, but this might be an easier way to integrate with it than talking to a running instance of KiCAD. Although KiCAD is more commonly used, I haven't personally found anything to dislodge me from PCB yet.

Patches gratefully accepted!

jaredjennings, 2020-08-31:
Maybe it only requires [0.6mm PCBs](https://www.reddit.com/r/MechanicalKeyboards/comments/ijwoe9/made_a_flexible_pcb_for_dactyl_dactyl_manuform/)? - This implementation of PCBs is not parameterized, and the keyboard was remodelled in Fusion 360, with the key positions fixed. So automatic PCB generation would still be novel.

This feature would likely require the key placement function to be usable in Clojure, not only OpenSCAD (#10): OpenSCAD can project 3D features down to 2D, but that is different from unfolding them to a flat plane. And now that I describe this that way, it sounds a lot like the problem of making paper mockups, for which I can't find an issue. Could have sworn I filed that one.

jaredjennings, 2020-08-31:
Well, that paper mockup ticket is now #61.

jaredjennings, 2020-09-07:
More on that one with the 0.6mm PCB, the [Bastyl](https://www.reddit.com/r/ErgoMechKeyboards/comments/inozxt/bastyl_with_flexible_pcb_mcu_holder_flush_usb_port/)

Supermagnum, 2020-09-07:
The PCB'S should optimally have one or two signal layers and two other layers acting as shield to minimize the risk for radio interference.

jaredjennings, 2020-09-08:
If the code to generate the PCB were written, adding the two extra layers would be a small extra effort. But I don't think it's necessary: the original Dactyl, and the Kinesis Advantage, are made with single-layer flexible printed circuits (FPCs). The signals travelling over these boards are maximally in the kilohertz range - all the multi-MHz signals where this consideration comes into play the most are on the Pro Micro or Teensy itself.

Supermagnum, 2020-09-09:
This is a better footprints library, it is scheduled to be merged in to the official Kicad GitHub library:
https://github.com/egladman/keebs.pretty
Merge request:
https://github.com/egladman/keebs.pretty/issues/7

jaredjennings, 2020-10-19:
The [Bastyl](https://www.reddit.com/r/ErgoMechKeyboards/comments/jdyc1q/bastyl_ergonomical_split_keyboard_3d_printed_case/) folks have managed this without wiggles and weaves, and without FPCs. (Good discussion about those in the comments, particularly cost/build-complexity tradeoffs.)

jaredjennings, 2020-10-19:
[Discussion](https://www.reddit.com/r/ErgoMechKeyboards/comments/jd2t6z/prototype_dactylmanuform_pcb/) about commercial use. It seems that the friend commercializing flexing FR4 PCBs for ergonomic keyboards on [cy384's blog](http://www.cy384.com/blog/flex-pcbs.html) ("wiggles and weaves" above) may have been u/smyjpmu at hidtech.ca?

This is something to watch out for: HIDTech's design appears to have been licensed CC-BY-NC, which is more restrictive than this project. So any appearance of copying that design here should be avoided. In fact, it may be impossible to develop this feature unimpeachably at this time.

jaredjennings, 2021-02-05:
More about HIDTech, Bastyl, u/smyjpmu (Anthony), and u/fmcraft (Quentin): https://www.reddit.com/r/ErgoMechKeyboards/comments/ld97a3/psa_anthony_usmyjpmu_is_a_con_artist_who_scammed/

equalunique, 2021-02-06:
A similar utility was created by Phil Hagelberg for his Atreus project: https://gitlab.com/technomancy/atreus/-/blob/efcf961441966f0dfb305b80bf78b3da62ca0f3f/atreus.rkt

Supermagnum, 2021-04-23:
Any updates on this?

jaredjennings, 2021-04-25:
I haven't done anything on the topic. Quentin's got PC boards at https://bastardkb.com, but they won't fit this keyboard with all of my layout tweaks. Thanks to a working prototype I made in the past few weeks, I've found my tweaks are horrible anyway, so go buy one of his keyboards :)

jaredjennings, 2021-08-23:
https://www.reddit.com/r/ErgoMechKeyboards/comments/p8m8h0/dactyl_flex_pcbs_arrived_from_jlcpcb_with/

Thread 60 (2020-08-17):

Support for raw data from http://www.keyboard-layout-editor.com

Supermagnum, 2020-08-17:
I think that support for raw data from the mentioned page should be implemented.
I dont understand Clojure at all.

A example :
http://www.keyboard-layout-editor.com/#/gists/c881b4af35745d286a7193ede6e3d1f9

jaredjennings, 2020-08-17:
This is a fantastic idea. The 2D coordinates from KLE could not be used directly, but the information they convey about adjacency and size of keys would be quite useful.

With that said: I spent a long period of time trying to make the code more flexible, so that I could describe the keyboard I wanted at a layer above the code. The more I tried to do that, the richer my keyboard description needed to become. After a while, I got tired of trying to build a keyboard language and not having a keyboard of my own, and decided to describe the keyboard using Clojure code. And I'm still not done with that!

So I do have a long-term goal of making it easier for people to prototype, build, and program ergonomic keyboards, and taking data from KLE would be an important step toward that. But before I get there, you could probably learn Clojure and write it up yourself.

Supermagnum, 2020-08-17:
I don't think I am capable of doing that.

Supermagnum, 2020-08-18:
Reddit user : https://www.reddit.com/user/ChirsF/ writes
Get a regex101 with the format output and separately what the expected input is and I’ll take a crack at a regex for it.
 in this thread:
https://www.reddit.com/r/ErgoMechKeyboards/comments/ibm4y0/feature_request_for_all_daktyl_keyboard_github/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

jaredjennings, 2020-08-18:
It's just JSON, isn't it?

Supermagnum, 2020-08-20:
> It's just JSON, isn't it?

Looks like it is.

Thread 62 (2020-10-25):

keycap collisions

jaredjennings, 2020-10-25:
With my heavily kluged key placement function, including splayed columns, column radius multipliers, and per-row alpha values, it can't be demonstrated that the keycaps won't overlap each other in the finished keyboard - and in a printed prototype, they in fact do.

I've made a new view that shows all the pairwise intersections between keycaps, but the keycap placement should be valid by construction.

And the individual keys in the outermost columns should be tipped inward. Not the whole column, because that would drive keys even farther apart.

jaredjennings, 2021-01-04:
Well - the way to really do this would be with some kind of solver. These exist already, but I'm not sure how to bring one to bear here, and I'm not going to figure it out right now, nor simplify the placement functions to be easier to work with. So I'm going to call the collision view a good solution for now, close this, and move on.

Closed 2021-01-04.

Thread 63 (2020-10-25):

less screws, and farther in

jaredjennings, 2020-10-25:
At present there are nine places where the frame screws onto the bottom. Lazily, I only attached three, and it worked fine. So until having three doesn't work, we should only have three.

The one toward the pinky should be moved in another column, though, so the keyboard can be lowered as much as possible.

Closed 2020-11-14.

Thread 64 (2020-10-25):

subtract screw hole pillars from screw holes

jaredjennings, 2020-10-25:
I made sure my frame screw holes would have a flat surface on top and bottom, for the screw head to rest on, and for the interface with the screw hole pillar on the bottom piece. But the screw hole pillar is wider than the room cut out for it at the bottom of the frame screw hole. Add it into frame-screw-hole-minus, and leave a tolerance too.

Closed 2020-11-14.

Thread 65 (2020-10-25):

try one-piece screw hole pillars

jaredjennings, 2020-10-25:
I printed the top of the screw hole pillars as a separate piece, so that no matter the orientation of the hole, the insert could be melted down perpendicular to the layers. That worked, but gluing the pieces was tedious and error-prone. Try just printing the whole thing as one piece. If it doesn't work, the eggcrate pattern added to ensure mating should be made deeper. It only just did its job.

Closed 2020-11-09.

Thread 66 (2020-10-25):

mid-century legs

jaredjennings, 2020-10-25:
I'm given to understand that the way a lot of pieces of Mid-Century Modern furniture had impossibly thin wooden legs is that the legs were built around steel rods. Perhaps the same could be done with plastic: a tapered plastic leg with a hole in the middle, around a piece of threaded rod screwed into a threaded insert. With due care, they could be removable for portability. The only downside I see is you need a decent amount of contact area with the desk to prevent slippage, so you'd have big knobby feet at the bottom of slender legs. It would be the furniture design equivalent of clown shoes.

I don't know if mid-century is where I'm headed with this thing, but by writing this down I won't have to remember it.

Thread 67 (2021-01-04):

make minimal sides thicker

jaredjennings, 2021-01-04:
The thing that gave this fork of the Dactyl its name was the marshmallowy sides. At this moment I'm not even trying to make them.  But the bare web I'm printing out, with the key holes in it, is too thin at the corners and edges. It cracks apart when you put a keyswitch in it. So the edges and corners of the web need to be wider, irrespective of the marshmallowy sides.

Thread 68 (2023-05-03):

Molded paper case

jaredjennings, 2023-05-03:
[This Youtube video](https://www.youtube.com/watch?v=0ItPfhx3ulw) talks about how you can 3d-print molds, which need to be quite sturdy (100% infill) and have occasional holes to let water out; then tear up cardboard and blend with water in a blender; put the slurry in half of the mold; and clamp the two halves mightily together. In this way you can mold things out of paper.

With the addition of some epoxy or plastic, this could be a super cheap and quick way to make a lot of keyboard cases - perhaps to build a keyswitch library, like on The Board Podcast, but ergonomic. Or the technique could be applied to the mockups I tried in the marshmallow branch that one time, with the sa-caps in their proper places, to make mockups in quantity much more easily than by means of origami (#61) .

The design for manufacturability of a cast paper case would be different from that of just FDM-printing a case. It may not be possible to cast the case in just one piece. Tenting and keywell curvature may necessitate some ingenuity to redirect clamping forces. Ribs or thick spots would need to be added. Jigs for cutting pieces to accurate sizes. The paper itself likely could not hold keyswitches. Hot glue would work even better to hold keyswitches in than it does on plastic though.
