jaredjennings/dactyl-keyboard/(commit log)

2020-10-02 add minimum viable bottom
    It is a series of pillars attached to a base, like the mockups but
    with screw hole pillars instead of sa-keycaps. I left the actual screw
    hole pillars off of the top, so that they can be printed in their
    native orientation, because the direction of the layer lines matters
    a good deal when melting threaded inserts in. They will need to be
    glued on.
    This is the simplest shape the frame can be screwed to, discarding all
    consideration of appearance or elegant function, because my thumbs
    hurt and I need a keyboard.
    [key-place.scad]
2020-10-02 while we're gluing, use wavy joints for screw pillars
2020-10-17 break out switch hole coloring
2020-10-17 bottom for photo vs. for printing
2020-10-17 really dig out the entire space above the screw head
2020-10-26 try to kluge thumb keys closer together
    [key-place.scad]
2020-11-09 try one-piece screw hole pillars (closes #65)
2020-11-14 screw hole pillar fixes (closes #64)
    This change fixes the location of the screw hole pillars of the
    mvbottom, placement of which was not taking into account the z-munging
    that the frame screw holes had, with which the screw hole pillars are
    intended to mate. Screw hole pillars (plus a tolerance) are now
    differenced from screw holes (#64). An annoying circular dependency is
    circumvented by an annoying manipulation.
2020-11-14 move frame screw hole up so its bottom is at z=0, matching pillar
2020-11-14 reduce number of screw holes; set them in better (fixes #63)
2021-01-04 tweak key-place to remove keycap overlaps (#62); ratchet beta up
    [key-place.scad]
2021-05-06 as printed. the tipped-in columns make my fingers hurt. ergo-fail.
    [teensy-holder.scad]
2021-05-06 increase bounding cube size to make up to a 6x6 case
2021-05-06 rename "hole" to "case" because that's what it is
2021-05-06 comment out wire posts: they do not work for me and i do not need them
2021-05-06 add built STL files for easy case use
    [case-left-4x5.stl, case-left-4x6.stl, case-left-5x6.stl, case-left-6x6.stl, case-right-4x5.stl, case-right-4x6.stl, case-right-5x6.stl, case-right-6x6.stl]
